Ketsusaur/task-autonomous-drawing-robot/README.md

# task-autonomous-drawing-robot
An autonomous mecanum wheeled mobile manipulation robot with a scissor lift and crank-release system for marker-pen operation.  
[View the PDF Report](ACS231%202024-25%20GP%20Final%20Report%20ACSE%20Group%2027.pdf).
