Ketsusaur/task-autonomous-drawing-robot/CAD Files/CAD Files/CTR-MIC-MNT.STEP

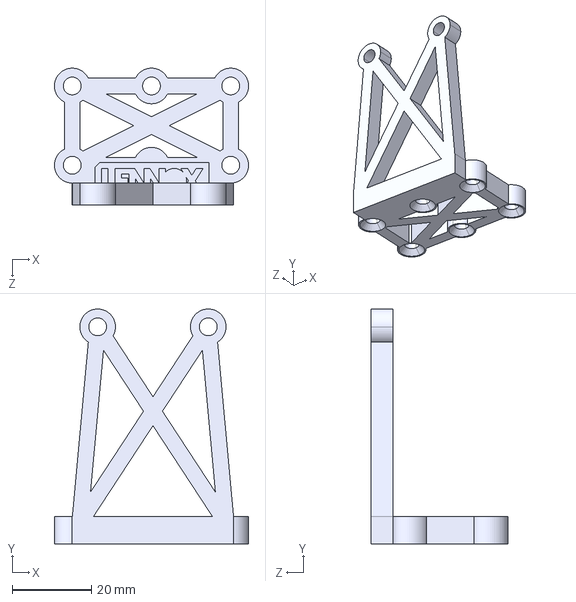
[picture p7: CAD file, 2025-10-27]
CAD Files/CAD Files/CTR-MIC-MNT.STEP
49.0 x 59.3 x 34.5 mm
