Ketsusaur/task-autonomous-drawing-robot/CAD Files/CAD Files/PWS-BHL-MNT.STEP

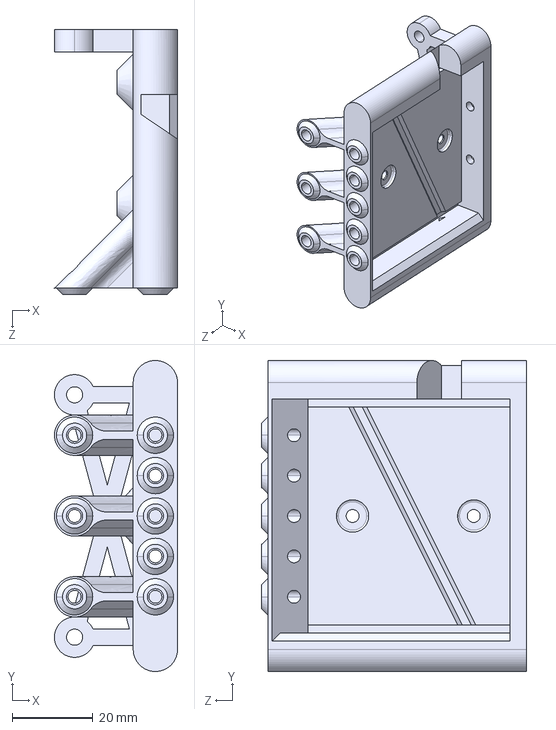
[picture p8: CAD file, 2025-10-27]
CAD Files/CAD Files/PWS-BHL-MNT.STEP
30.5 x 77.0 x 65.5 mm
