Ketsusaur/task-autonomous-drawing-robot/CAD Files/CAD Files/MAN-SCL-AXL.STEP

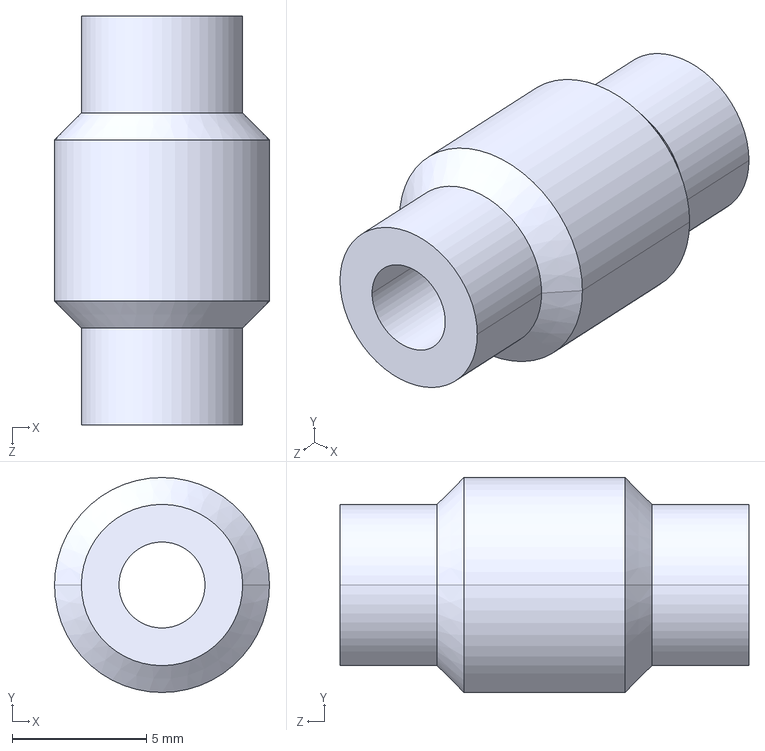
[picture p9: CAD file, 2025-10-27]
CAD Files/CAD Files/MAN-SCL-AXL.STEP
8.00 x 8.00 x 15.2 mm
