Ketsusaur/task-autonomous-drawing-robot/CAD Files/CAD Files/MAN-EEF-SLI.step

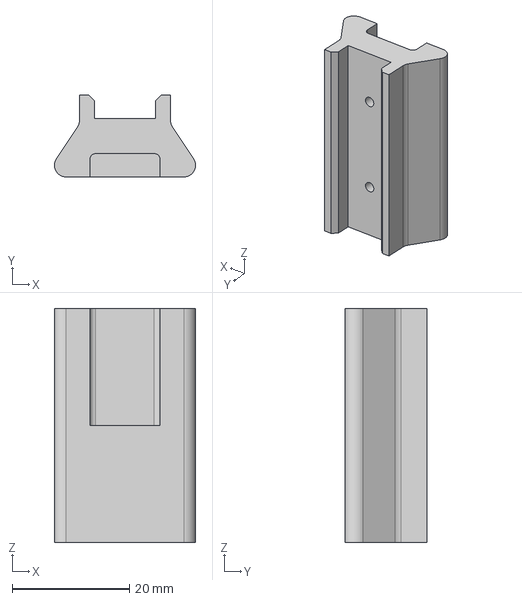
[picture p10: CAD file, 2025-10-27]
CAD Files/CAD Files/MAN-EEF-SLI.step
24.1 x 14.0 x 40.0 mm
