Ketsusaur/task-autonomous-drawing-robot/CAD Files/CAD Files/MAN-EEF-CRH.step

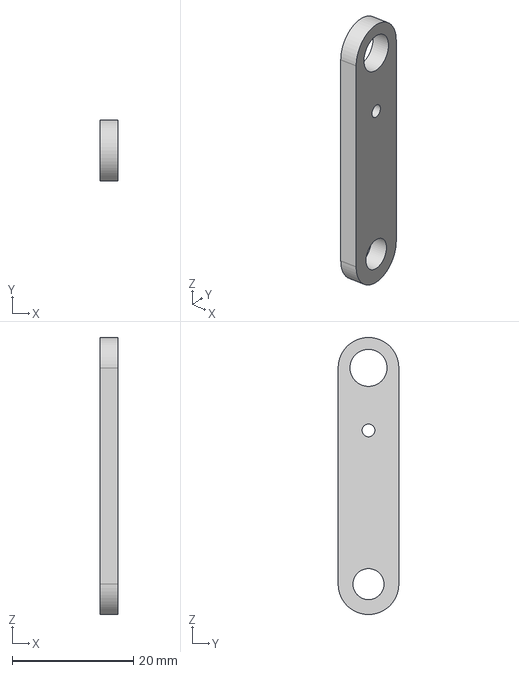
[picture p11: CAD file, 2025-10-27]
CAD Files/CAD Files/MAN-EEF-CRH.step
3.00 x 10.0 x 45.6 mm
