Ketsusaur/task-autonomous-drawing-robot/CAD Files/CAD Files/MAN-SCL-MA2.STEP

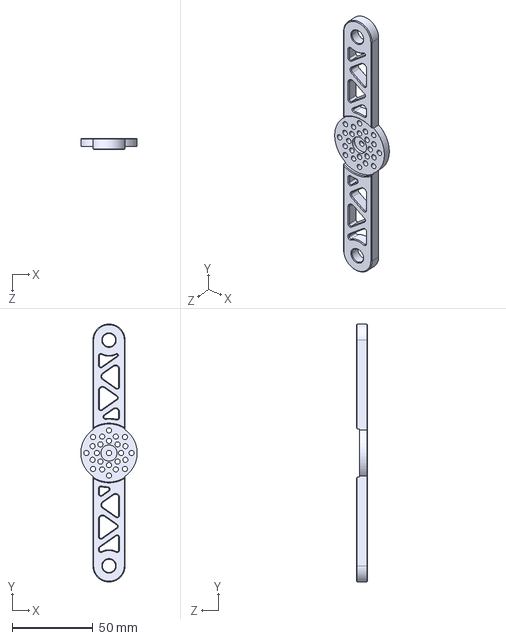
[picture p12: CAD file, 2025-10-27]
CAD Files/CAD Files/MAN-SCL-MA2.STEP
35.0 x 160.0 x 7.00 mm
