Ketsusaur/task-autonomous-drawing-robot/CAD Files/CAD Files/MAN-SCL-MA1.STEP

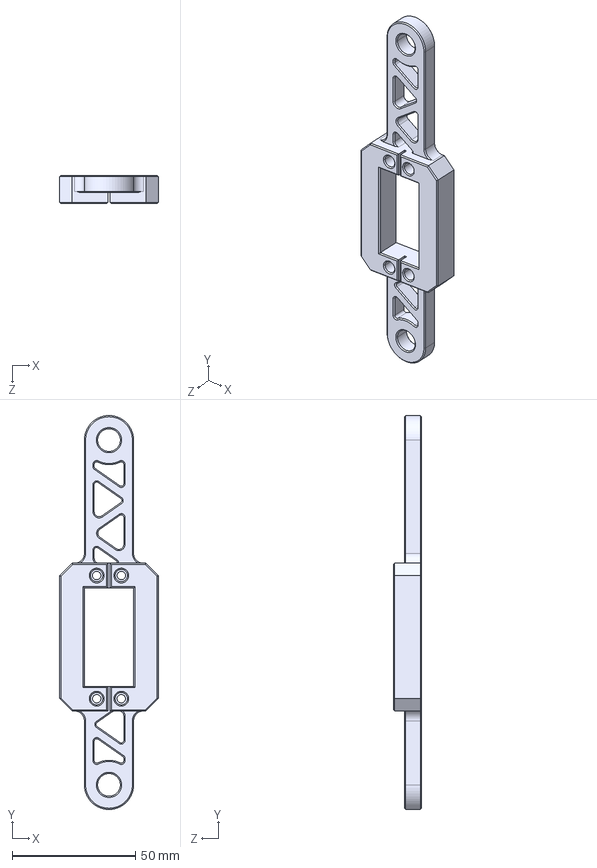
[picture p13: CAD file, 2025-10-27]
CAD Files/CAD Files/MAN-SCL-MA1.STEP
40.0 x 160.0 x 11.5 mm
