Ketsusaur/task-autonomous-drawing-robot/CAD Files/CAD Files/SEN-NVG-MNT.STEP

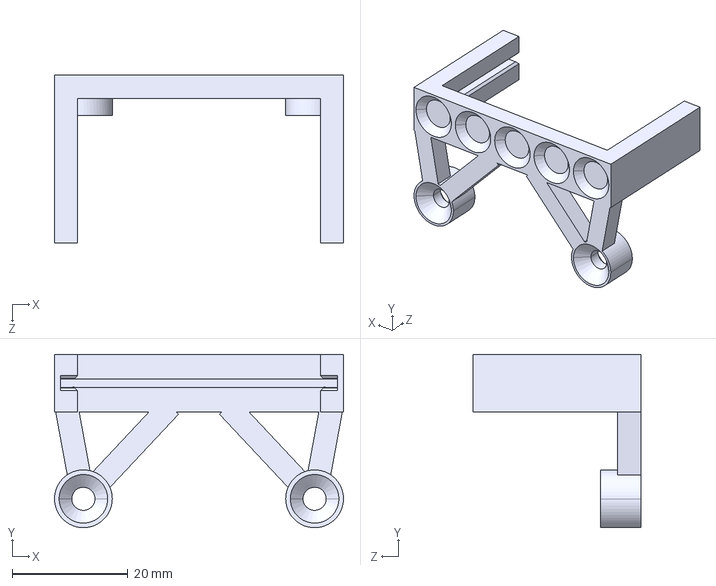
[picture p14: CAD file, 2025-10-27]
CAD Files/CAD Files/SEN-NVG-MNT.STEP
50.0 x 30.0 x 29.0 mm
