Ketsusaur/task-autonomous-drawing-robot/CAD Files/CAD Files/MAN-SCL-LPB.STEP

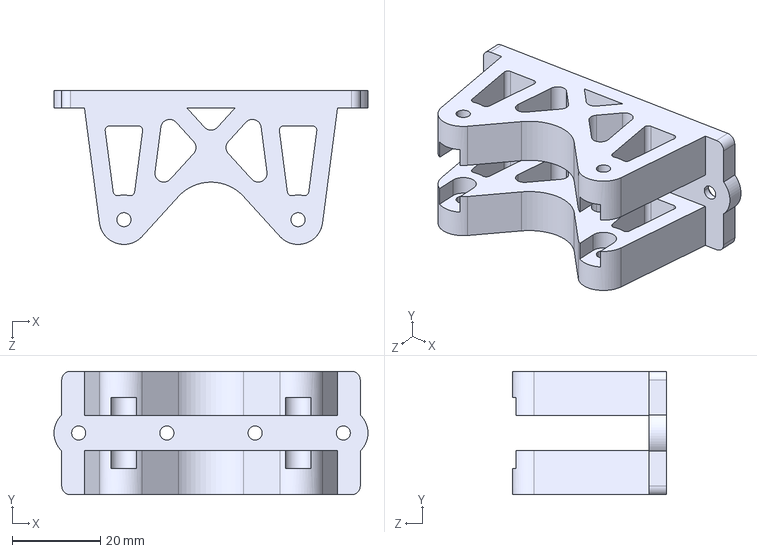
[picture p15: CAD file, 2025-10-27]
CAD Files/CAD Files/MAN-SCL-LPB.STEP
71.2 x 28.0 x 34.9 mm
