Ketsusaur/task-autonomous-drawing-robot/CAD Files/CAD Files/LOC-RNG-MSH.STEP

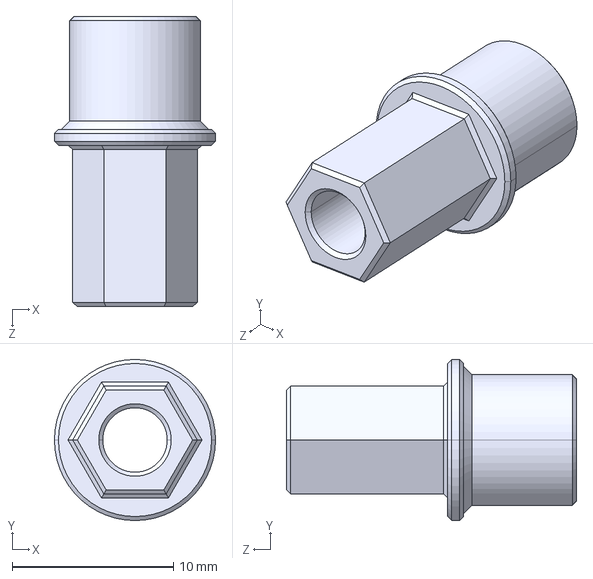
[picture p16: CAD file, 2025-10-27]
CAD Files/CAD Files/LOC-RNG-MSH.STEP
10.0 x 10.0 x 18.0 mm
