Ketsusaur/task-autonomous-drawing-robot/CAD Files/CAD Files/MAN-EEF-PLF.step

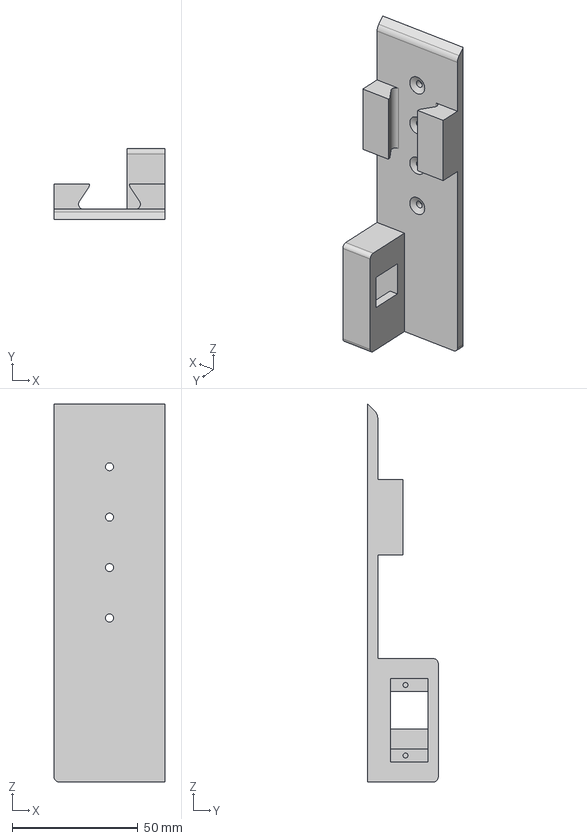
[picture p17: CAD file, 2025-10-27]
CAD Files/CAD Files/MAN-EEF-PLF.step
44.0 x 28.0 x 150.0 mm
