Ketsusaur/task-autonomous-drawing-robot/CAD Files/CAD Files/LOC-RNG-MNT.STEP

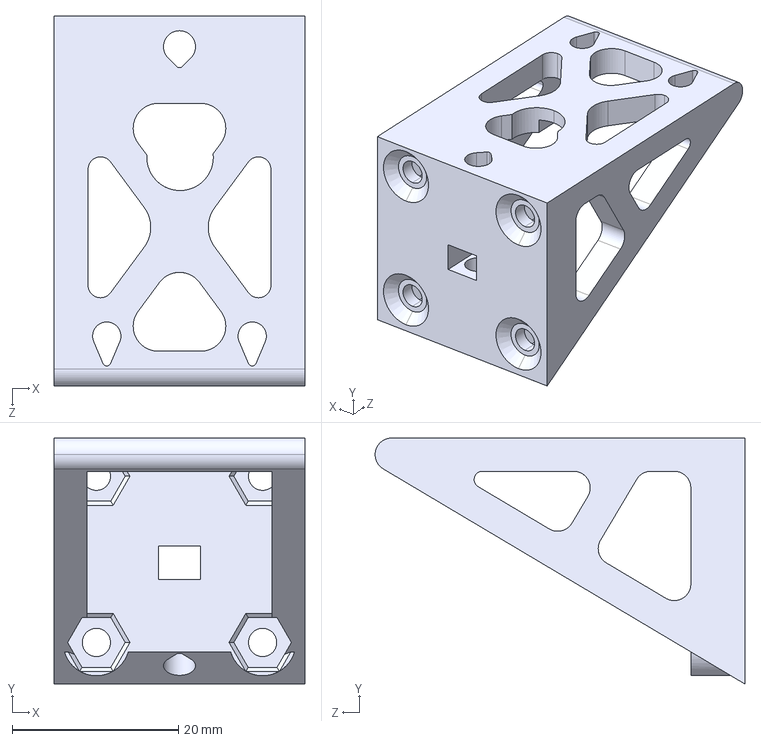
[picture p18: CAD file, 2025-10-27]
CAD Files/CAD Files/LOC-RNG-MNT.STEP
30.2 x 29.6 x 44.5 mm
