Ketsusaur/task-autonomous-drawing-robot/CAD Files/CAD Files/LOC-CHA.STEP

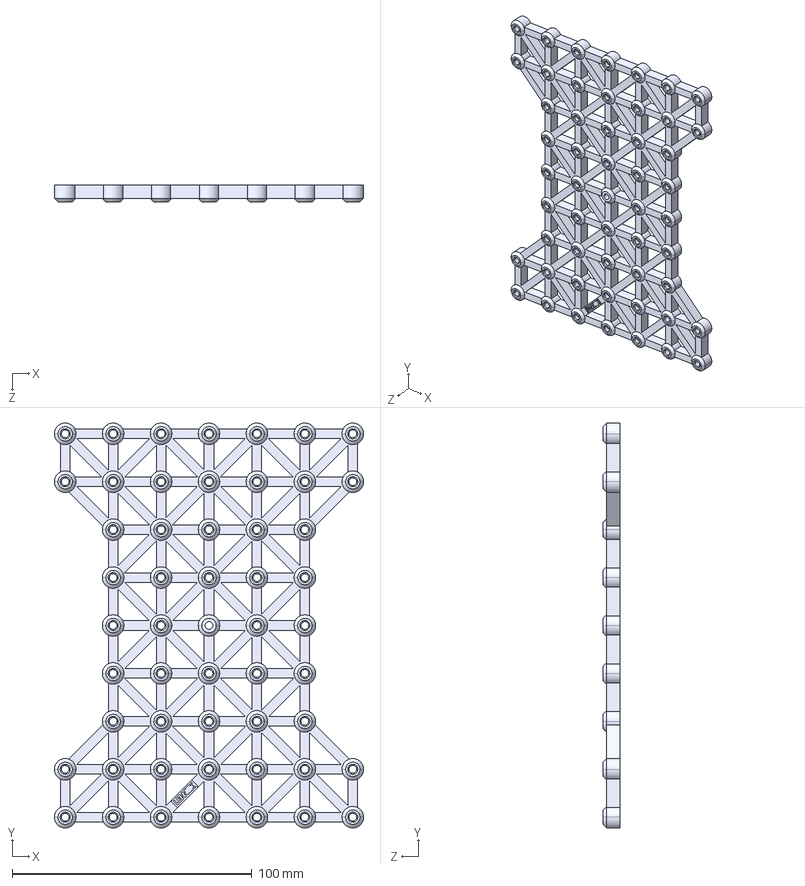
[picture p19: CAD file, 2025-10-27]
CAD Files/CAD Files/LOC-CHA.STEP
129.0 x 169.0 x 7.10 mm
