Ketsusaur/task-autonomous-drawing-robot/CAD Files/CAD Files/MAN-EEF-EGP.step

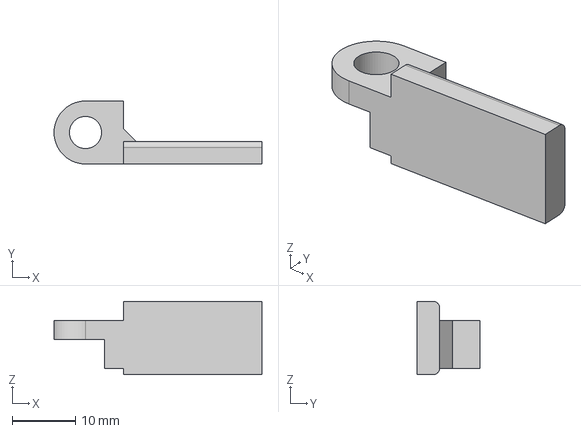
[picture p20: CAD file, 2025-10-27]
CAD Files/CAD Files/MAN-EEF-EGP.step
33.0 x 10.0 x 11.6 mm
