Ketsusaur/task-autonomous-drawing-robot/CAD Files/CAD Files/MAN-EEF-CLA.step

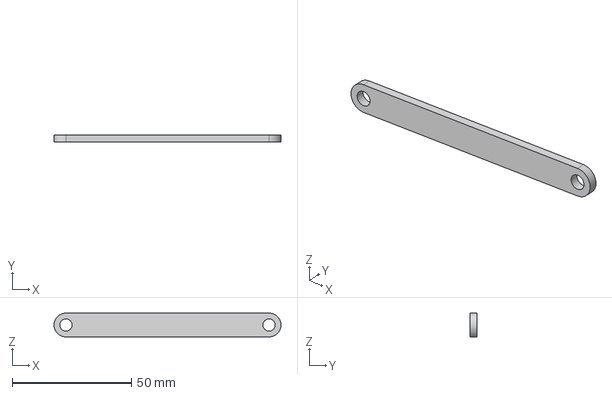
[picture p21: CAD file, 2025-10-27]
CAD Files/CAD Files/MAN-EEF-CLA.step
95.1 x 3.00 x 10.0 mm
