Ketsusaur/task-autonomous-drawing-robot/CAD Files/CAD Files/CTR-MIC-MPL.STEP

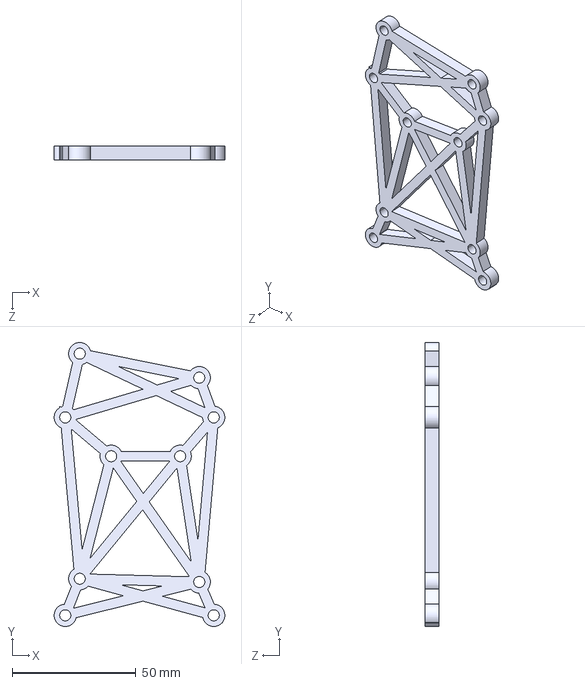
[picture p22: CAD file, 2025-10-27]
CAD Files/CAD Files/CTR-MIC-MPL.STEP
69.0 x 114.8 x 5.50 mm
